ua1cfm/G5500-ESP32S3-Controller/Схема_G-5500 CONTROLLER — ESP32-S3-DevKitC-1 N16R8_TFT 2.8in ILI9341 SPI 320x240.pdf

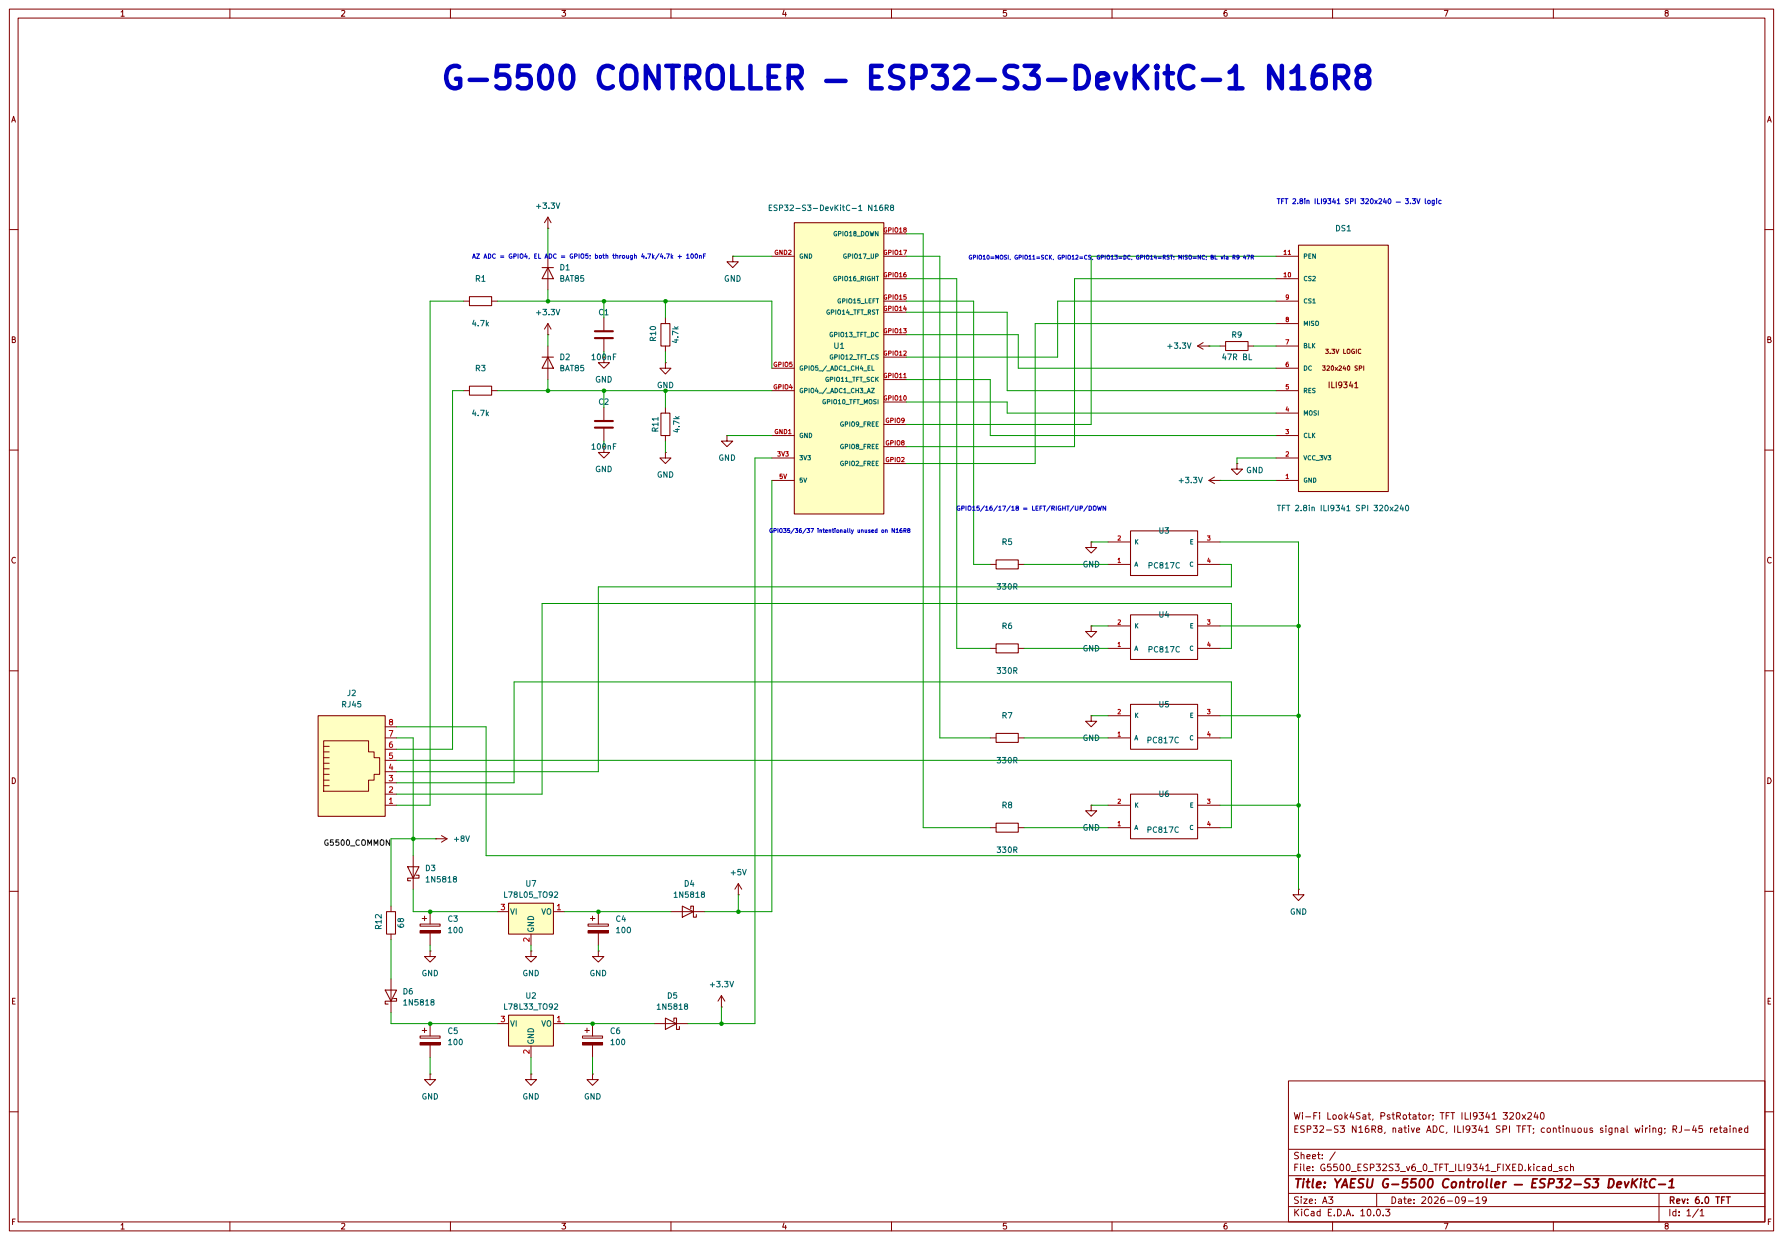
[picture p1: page 1]
