ua1cfm/G5500-ESP32S3-Controller/Схема_G-5500 CONTROLLER — ESP32-S3-DevKitC-1 N16R8.pdf

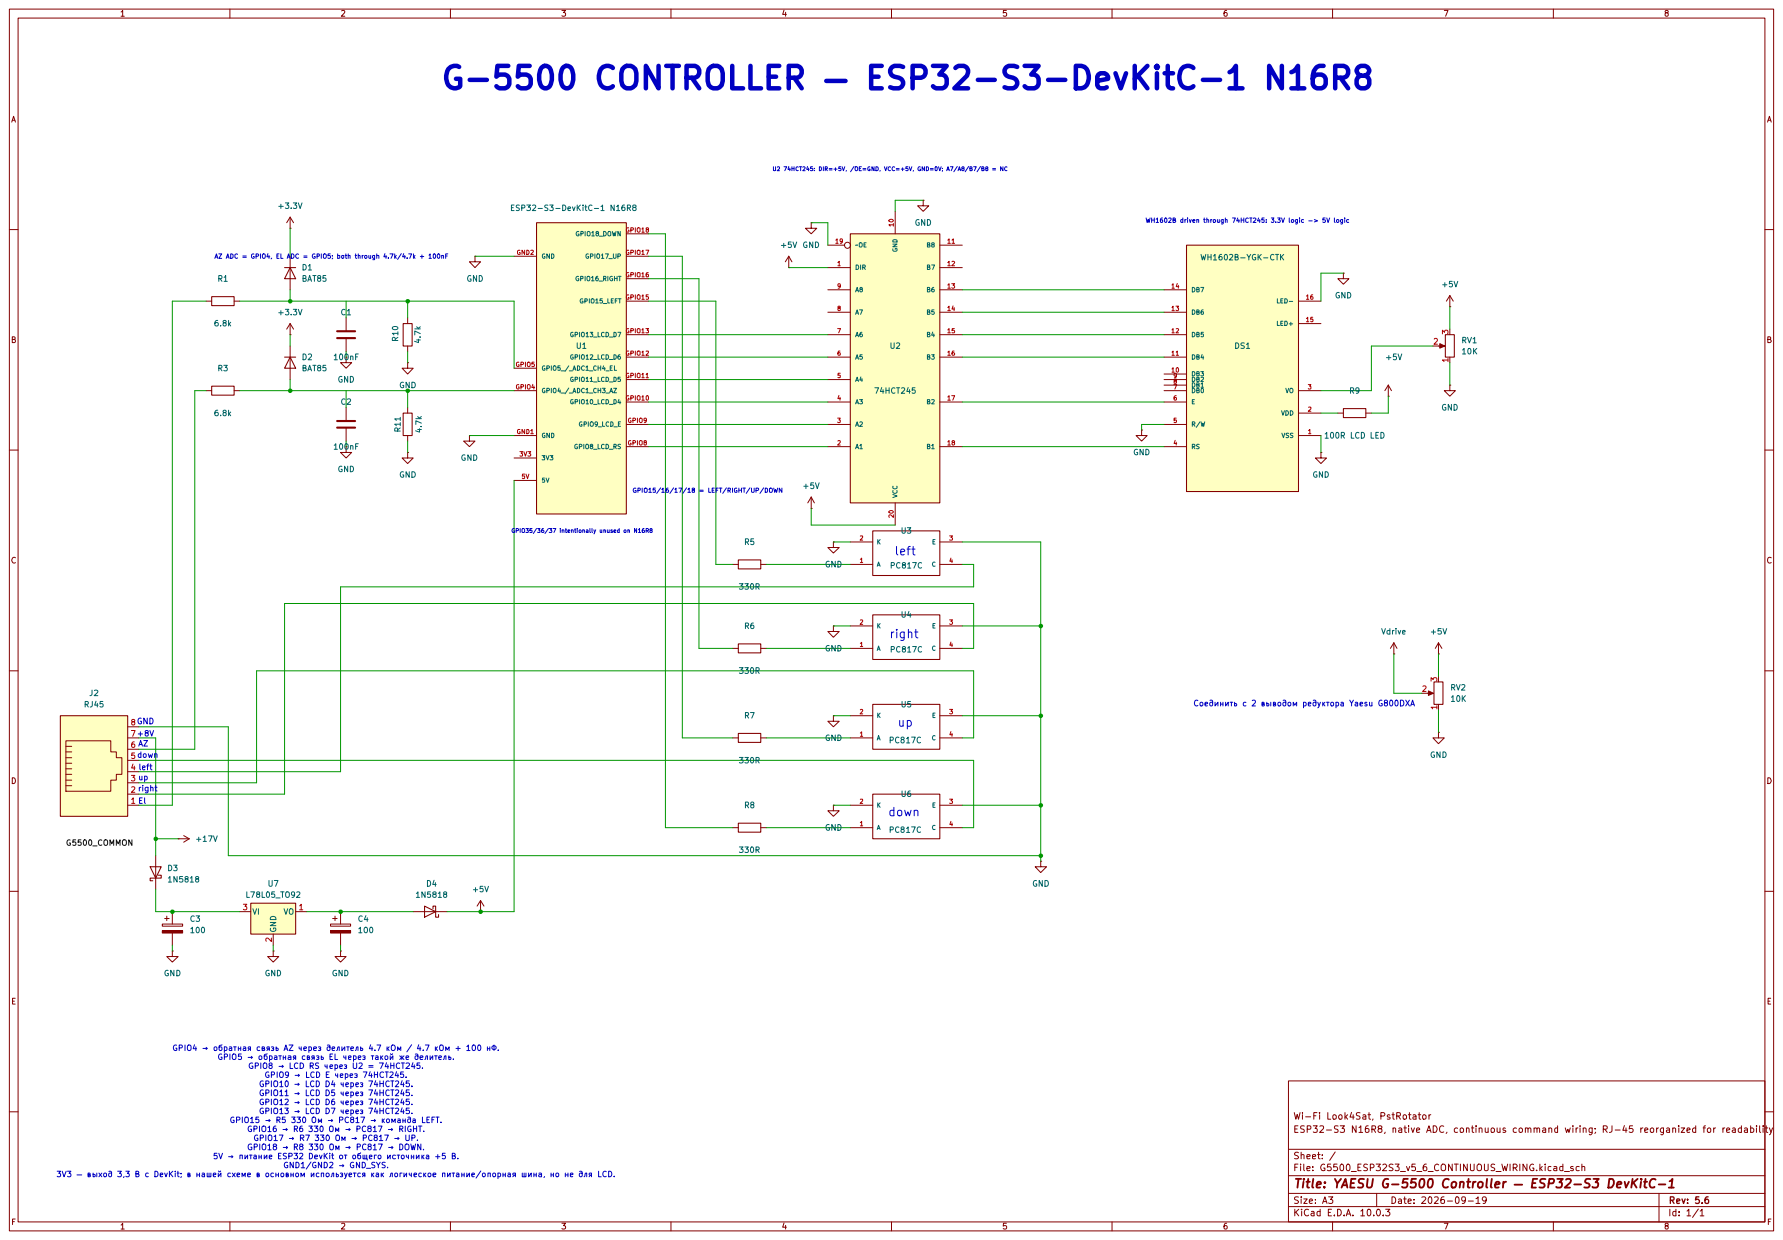
[picture p2: page 1]
